labodj/resol-vbus-interface/docs/images/pcb-bottom.png

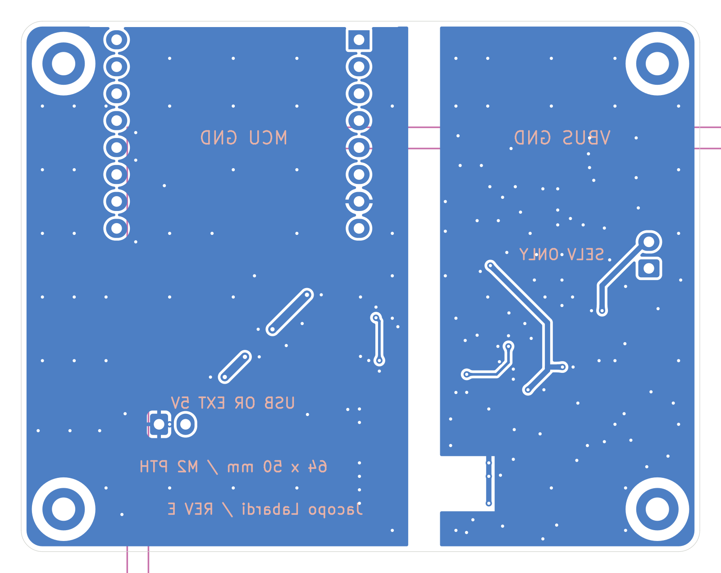
docs/images/pcb-bottom.png
