labodj/resol-vbus-interface/docs/schematic.png

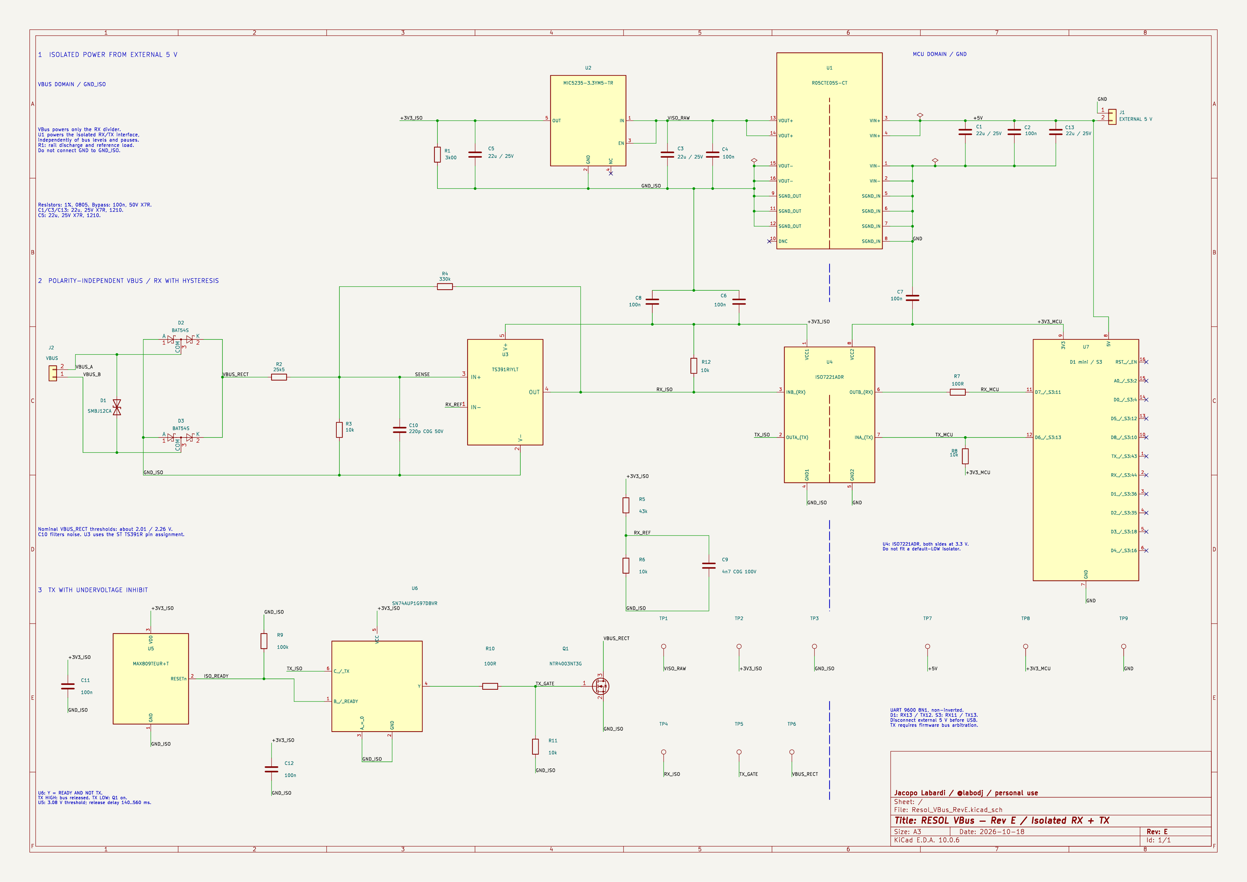
docs/schematic.png
