labodj/resol-vbus-interface/fabrication/bom.csv

References | Value | Footprint | Manufacturer | MPN | Quantity
C1,C3,C5,C13 | 22u / 25V | Capacitor_SMD:C_1210_3225Metric | Samsung Electro-Mechanics | CL32B226KAJNNNE | 4
C2,C4,C6-C8,C11,C12 | 100n | Capacitor_SMD:C_0805_2012Metric | Yageo | CC0805KRX7R9BB104 | 7
C9 | 4n7 C0G 100V | Capacitor_SMD:C_0805_2012Metric | KEMET | C0805C472J1GACTU | 1
C10 | 220p C0G 50V | Capacitor_SMD:C_0805_2012Metric | KEMET | C0805C221J5GACTU | 1
D1 | SMBJ12CA | Diode_SMD:D_SMB | Vishay | SMBJ12CA-E3/52 | 1
D2,D3 | BAT54S | Package_TO_SOT_SMD:SOT-23 | Diodes Incorporated | BAT54SQ-7-F | 2
J1 | EXTERNAL 5 V | Connector_JST:JST_XH_B2B-XH-A_1x02_P2.50mm_Vertical | JST | B2B-XH-A | 1
J2 | VBUS | Connector_JST:JST_XH_B2B-XH-A_1x02_P2.50mm_Vertical | JST | B2B-XH-A | 1
Q1 | NTR4003NT3G | Package_TO_SOT_SMD:SOT-23 | onsemi | NTR4003NT3G | 1
R1 | 3k00 | Resistor_SMD:R_0805_2012Metric | Yageo | RC0805FR-073KL | 1
R2 | 25k5 | Resistor_SMD:R_0805_2012Metric | Yageo | RC0805FR-0725K5L | 1
R3,R6,R8,R11,R12 | 10k | Resistor_SMD:R_0805_2012Metric | Yageo | RC0805FR-0710KL | 5
R4 | 330k | Resistor_SMD:R_0805_2012Metric | Yageo | RC0805FR-07330KL | 1
R5 | 43k | Resistor_SMD:R_0805_2012Metric | Yageo | RC0805FR-0743KL | 1
R7,R10 | 100R | Resistor_SMD:R_0805_2012Metric | Yageo | RC0805FR-07100RL | 2
R9 | 100k | Resistor_SMD:R_0805_2012Metric | Yageo | RC0805FR-07100KL | 1
U1 | R05CTE05S-CT | ResolVBusD:RECOM_R05CTE05S | RECOM | R05CTE05S-CT | 1
U2 | MIC5235-3.3YM5-TR | Package_TO_SOT_SMD:SOT-23-5 | Microchip Technology | MIC5235-3.3YM5-TR | 1
U3 | TS391RIYLT | Package_TO_SOT_SMD:SOT-23-5 | STMicroelectronics | TS391RIYLT | 1
U4 | ISO7221ADR | Package_SO:SOIC-8_3.9x4.9mm_P1.27mm | Texas Instruments | ISO7221ADR | 1
U5 | MAX809TEUR+T | Package_TO_SOT_SMD:SOT-23 | Analog Devices / Maxim | MAX809TEUR+T | 1
U6 | SN74AUP1G97DBVR | Package_TO_SOT_SMD:SOT-23-6 | Texas Instruments | SN74AUP1G97DBVR | 1
U7 | D1 mini / S3 | ResolVBusD:Wemos_D1_mini_2x08 | LOLIN / WEMOS |  | 1
