labodj/resol-vbus-interface/docs/schematic.pdf

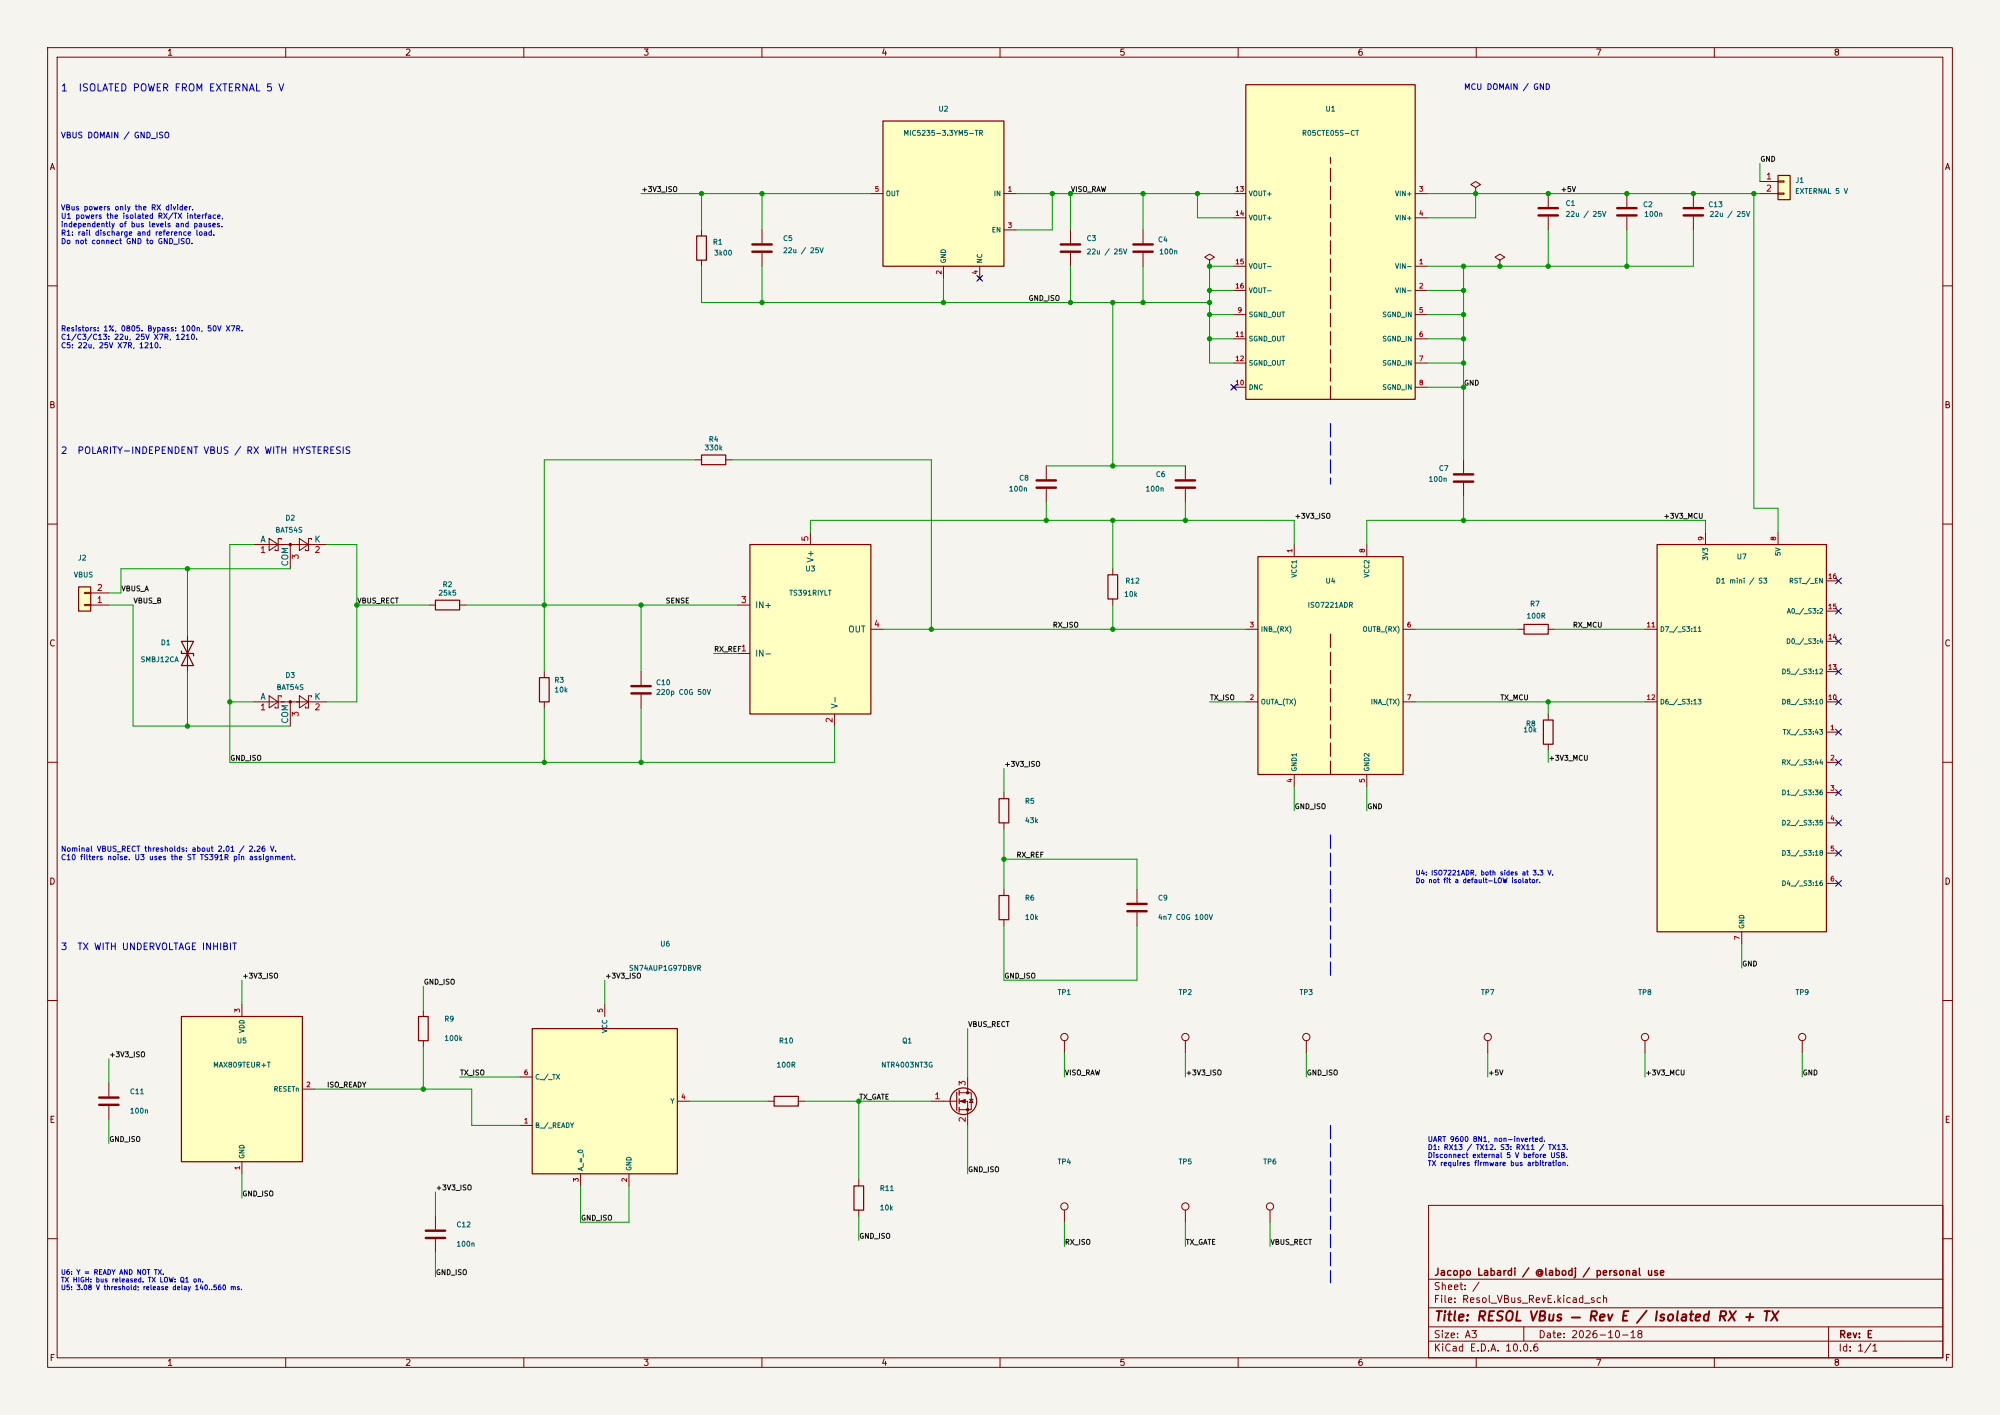
[picture p5: page 1]

Resistors: 1%, 0805. Bypass: 100n, 50V X7R. C1/C3/C13: 22u, 25V X7R, 1210. C5: 22u, 25V X7R, 1210. VBUS DOMAIN / GND_ISO 1 ISOLATED POWER FROM EXTERNAL 5 V

VBus powers only the RX divider. U1 powers the isolated RX/TX interface,

independently of bus levels and pauses. R1: rail discharge and reference load. Do not connect GND to GND_ISO.

Nominal VBUS_RECT thresholds: about 2.01 / 2.26 V. C10 filters noise. U3 uses the ST TS391R pin assignment.

U4: ISO7221ADR, both sides at 3.3 V. Do not fit a default-LOW isolator.

U6: Y = READY AND NOT TX. TX HIGH: bus released. TX LOW: Q1 on. U5: 3.08 V threshold; release delay 140..560 ms.

Jacopo Labardi / @labodj / personal use
Sheet: /
File: Resol_VBus_RevE.kicad_sch
Title: RESOL VBus — Rev E / Isolated RX + TX

Size: A3 | Rev: E | F Date: 2026-10-18
KiCad E.D.A. 10.0.6 | Id: 1/1
