labodj/resol-vbus-interface/hardware/rev-e/Resol_VBus_RevE.kicad_pcb

## KiCad design hardware/rev-e/Resol_VBus_RevE.kicad_pcb (2026-10-18)

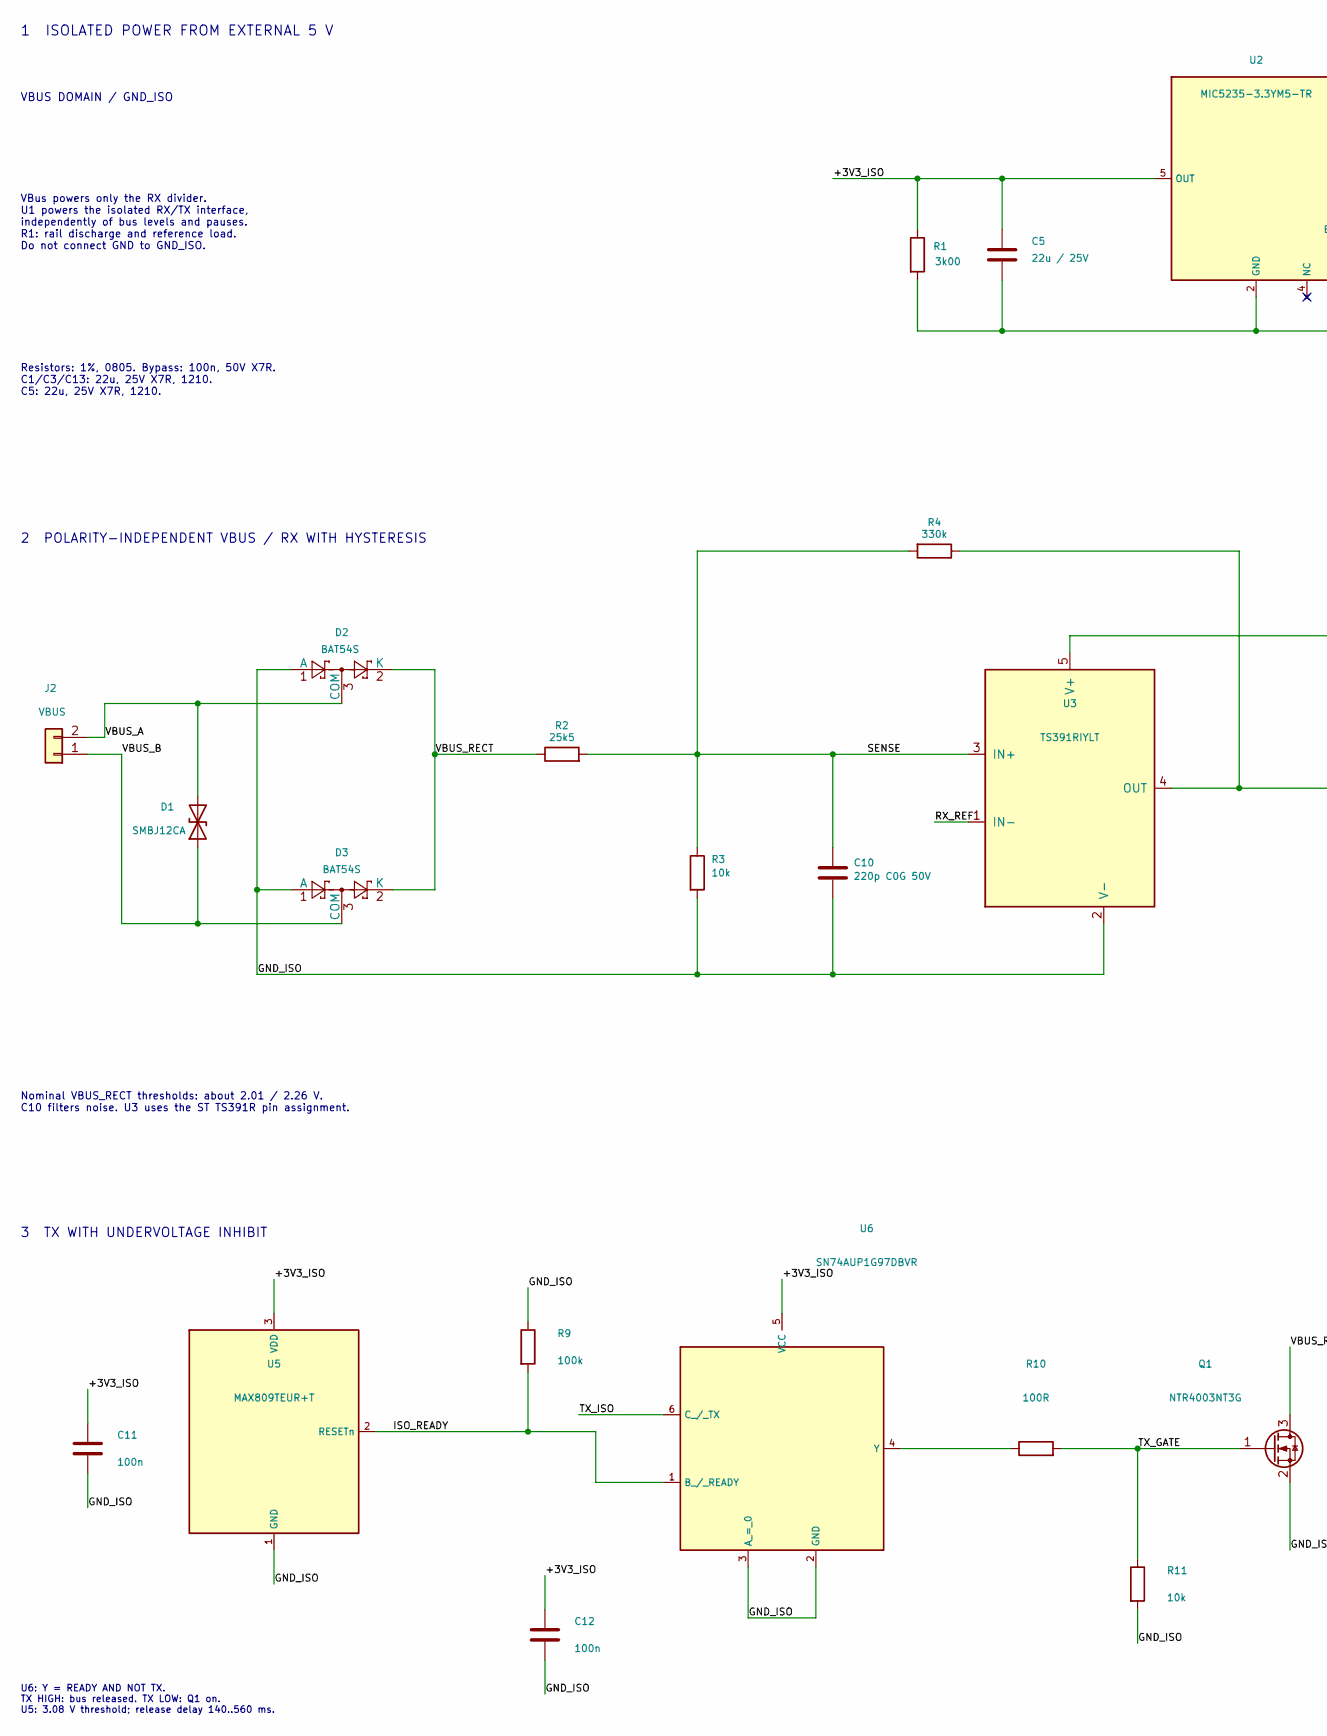
[picture p6: schematic Resol_VBus_RevE.kicad_sch, RESOL VBus — Rev E / Isolated RX + TX, part in row 1, column 1]

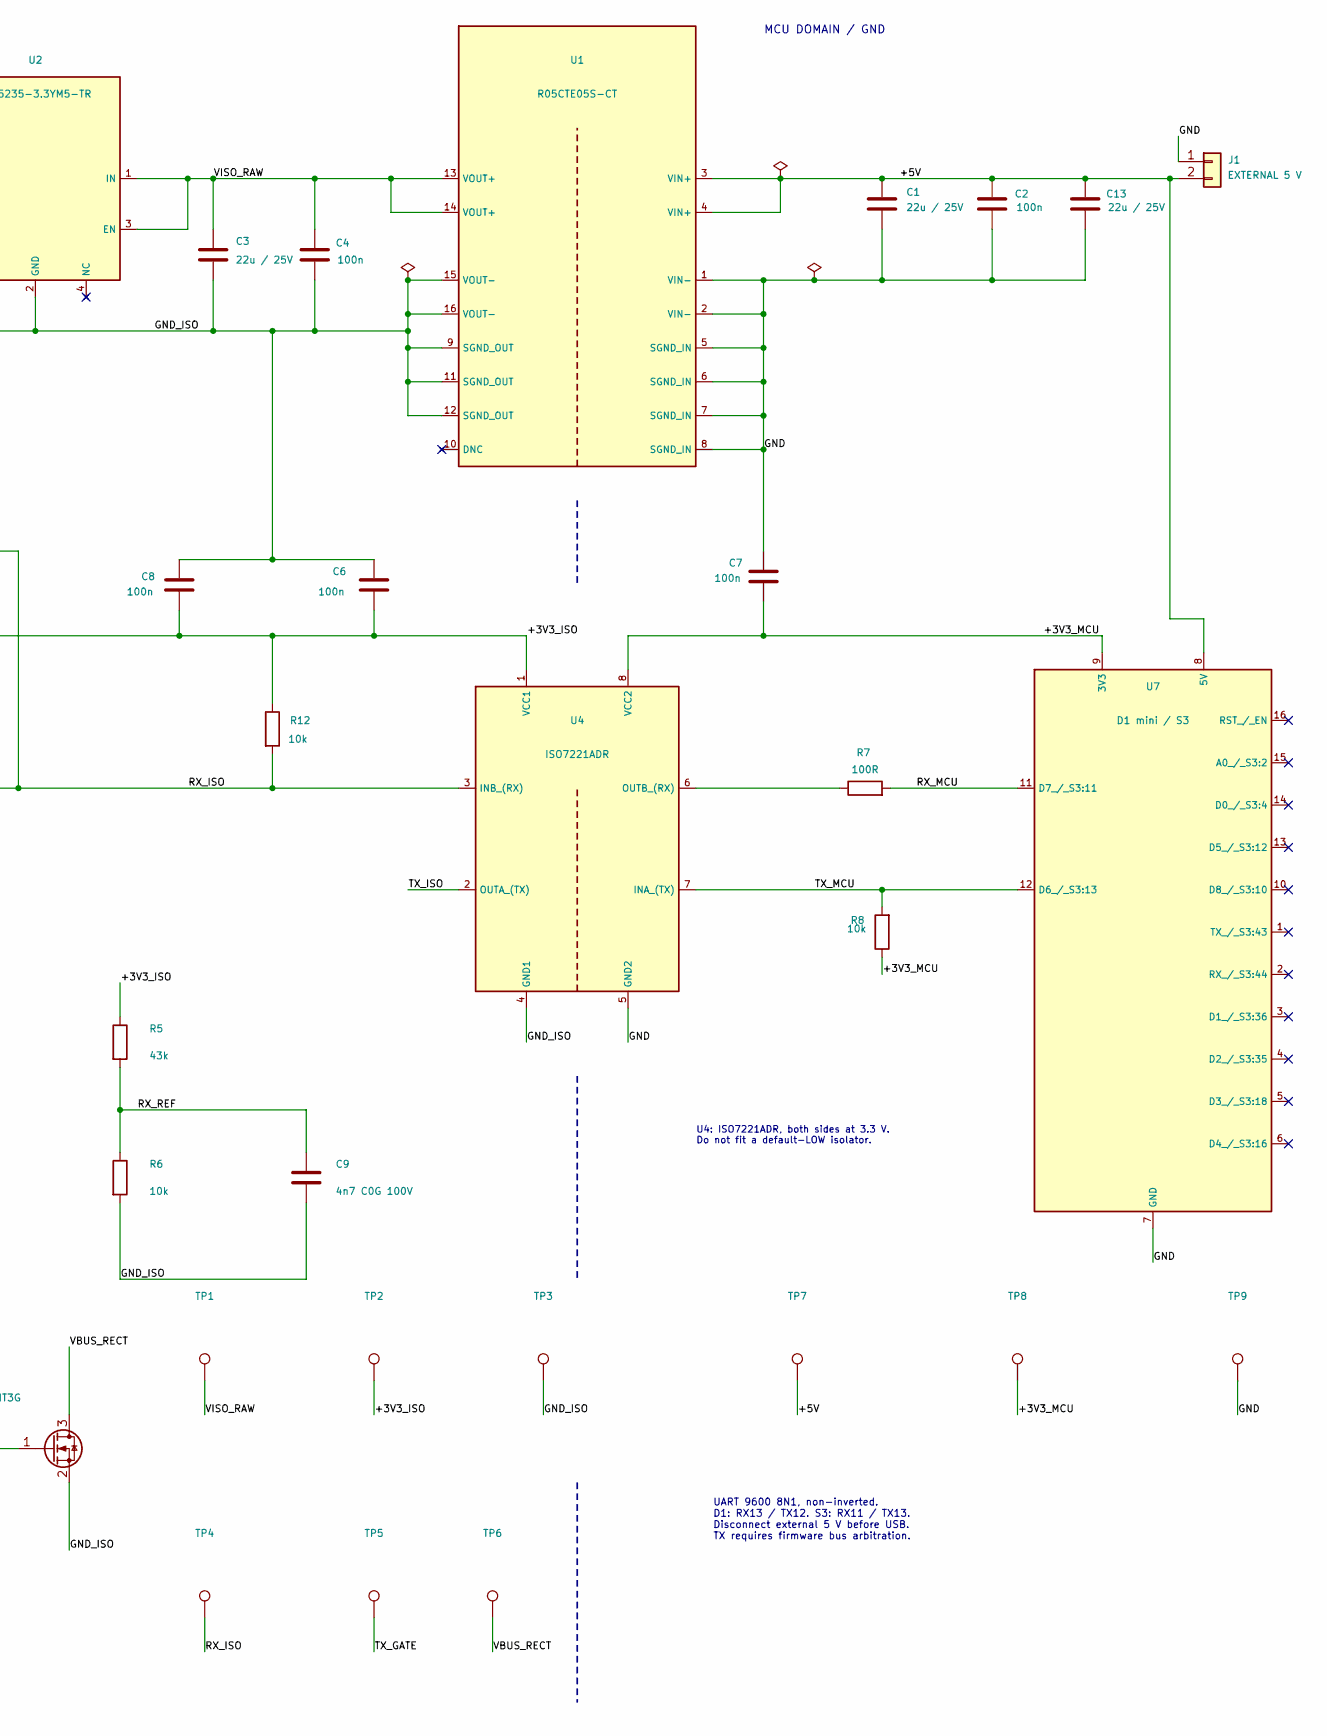
[picture p7: schematic Resol_VBus_RevE.kicad_sch, RESOL VBus — Rev E / Isolated RX + TX, part in row 1, column 2]

Parts:
C1, C3, C5, C13: 22u / 25V; C_1210_3225Metric; MPN CL32B226KAJNNNE
C2, C4, C6, C7, C8, C11, C12: 100n; C_0805_2012Metric; MPN CC0805KRX7R9BB104
C9: 4n7 C0G 100V; C_0805_2012Metric; MPN C0805C472J1GACTU
C10: 220p C0G 50V; C_0805_2012Metric; MPN C0805C221J5GACTU
D1: SMBJ12CA; D_SMB; MPN SMBJ12CA-E3/52
D2, D3: BAT54S; SOT-23; MPN BAT54SQ-7-F
J1: EXTERNAL 5 V; JST_XH_B2B-XH-A_1x02_P2.50mm_Vertical; MPN B2B-XH-A
J2: VBUS; JST_XH_B2B-XH-A_1x02_P2.50mm_Vertical; MPN B2B-XH-A
Q1: NTR4003NT3G; SOT-23; MPN NTR4003NT3G
R1: 3k00; R_0805_2012Metric; MPN RC0805FR-073KL
R2: 25k5; R_0805_2012Metric; MPN RC0805FR-0725K5L
R3, R6, R8, R11, R12: 10k; R_0805_2012Metric; MPN RC0805FR-0710KL
R4: 330k; R_0805_2012Metric; MPN RC0805FR-07330KL
R5: 43k; R_0805_2012Metric; MPN RC0805FR-0743KL
R7, R10: 100R; R_0805_2012Metric; MPN RC0805FR-07100RL
R9: 100k; R_0805_2012Metric; MPN RC0805FR-07100KL
TP1: VISO_RAW; TestPoint_Pad_D1.0mm
TP2: +3V3_ISO; TestPoint_Pad_D1.0mm
TP3: GND_ISO; TestPoint_Pad_D1.0mm
TP4: RX_ISO; TestPoint_Pad_D1.0mm
TP5: TX_GATE; TestPoint_Pad_D1.0mm
TP6: VBUS_RECT; TestPoint_Pad_D1.0mm
TP7: +5V; TestPoint_Pad_D1.0mm
TP8: +3V3_MCU; TestPoint_Pad_D1.0mm
TP9: GND; TestPoint_Pad_D1.0mm
U1: R05CTE05S-CT; RECOM_R05CTE05S; MPN R05CTE05S-CT
U2: MIC5235-3.3YM5-TR; SOT-23-5; MPN MIC5235-3.3YM5-TR
U3: TS391RIYLT; SOT-23-5; MPN TS391RIYLT
U4: ISO7221ADR; SOIC-8_3.9x4.9mm_P1.27mm; MPN ISO7221ADR
U5: MAX809TEUR+T; SOT-23; MPN MAX809TEUR+T
U6: SN74AUP1G97DBVR; SOT-23-6; MPN SN74AUP1G97DBVR
U7: D1 mini / S3; Wemos_D1_mini_2x08

Connections:
/+3V3_ISO: C5.1, C6.1, C8.1, C11.1, C12.1, R1.1, R5.1, R12.1, TP2.1 (1_1), U2.5 (OUT), U3.5 (V+), U4.1 (VCC1), U5.3 (VDD), U6.5 (VCC)
/+3V3_MCU: C7.1, R8.1, TP8.1 (1_1), U4.8 (VCC2), U7.9 (3V3)
/+5V: C1.1, C2.1, C13.1, J1.2, TP7.1 (1_1), U1.3 (VIN+), U1.4 (VIN+), U7.8 (5V)
/GND: C1.2, C2.2, C7.2, C13.2, J1.1, TP9.1 (1_1), U1.1 (VIN-), U1.2 (VIN-), U1.5 (SGND_IN), U1.6 (SGND_IN), U1.7 (SGND_IN), U1.8 (SGND_IN), U4.5 (GND2), U7.7 (GND)
/GND_ISO: C3.2, C4.2, C5.2, C6.2, C8.2, C9.2, C10.2, C11.2, C12.2, D2.1 (A), D3.1 (A), Q1.2 (S), R1.2, R3.2, R6.2, R9.1, R11.2, TP3.1 (1_1), U1.9 (SGND_OUT), U1.11 (SGND_OUT), U1.12 (SGND_OUT), U1.15 (VOUT-), U1.16 (VOUT-), U2.2 (GND), U3.2 (V-), U4.4 (GND1), U5.1 (GND), U6.2 (GND), U6.3 (A_=_0)
/ISO_READY: R9.2, U5.2 (RESETn), U6.1 (B_/_READY)
/RX_ISO: R4.1, R12.2, TP4.1 (1_1), U3.4 (OUT), U4.3 (INB_(RX))
/RX_MCU: R7.2, U7.11 (D7_/_S3:11)
/RX_REF: C9.1, R5.2, R6.1, U3.1 (IN-)
/SENSE: C10.1, R2.2, R3.1, R4.2, U3.3 (IN+)
/TX_GATE: Q1.1 (G), R10.2, R11.1, TP5.1 (1_1)
/TX_ISO: U4.2 (OUTA_(TX)), U6.6 (C_/_TX)
/TX_MCU: R8.2, U4.7 (INA_(TX)), U7.12 (D6_/_S3:13)
/VBUS_A: D1.2 (A2), D2.3 (COM), J2.2
/VBUS_B: D1.1 (A1), D3.3 (COM), J2.1
/VBUS_RECT: D2.2 (K), D3.2 (K), Q1.3 (D), R2.1, TP6.1 (1_1)
/VISO_RAW: C3.1, C4.1, TP1.1 (1_1), U1.13 (VOUT+), U1.14 (VOUT+), U2.1 (IN), U2.3 (EN)
unnamed: R7.1, U4.6 (OUTB_(RX))
unnamed: R10.1, U6.4 (Y)

Notes on the sheet:
2 POLARITY-INDEPENDENT VBUS / RX WITH HYSTERESIS
Resistors: 1%, 0805. Bypass: 100n, 50V X7R. C1/C3/C13: 22u, 25V X7R, 1210. C5: 22u, 25V X7R, 1210.
UART 9600 8N1, non-inverted. D1: RX13 / TX12. S3: RX11 / TX13. Disconnect external 5 V before USB. TX requires firmware bus arbitration.
3 TX WITH UNDERVOLTAGE INHIBIT
Nominal VBUS_RECT thresholds: about 2.01 / 2.26 V. C10 filters noise. U3 uses the ST TS391R pin assignment.
MCU DOMAIN / GND
VBUS DOMAIN / GND_ISO
1 ISOLATED POWER FROM EXTERNAL 5 V
U4: ISO7221ADR, both sides at 3.3 V. Do not fit a default-LOW isolator.
U6: Y = READY AND NOT TX. TX HIGH: bus released. TX LOW: Q1 on. U5: 3.08 V threshold; release delay 140..560 ms.
VBus powers only the RX divider. U1 powers the isolated RX/TX interface, independently of bus levels and pauses. R1: rail discharge and reference load. Do not connect GND to GND_ISO.

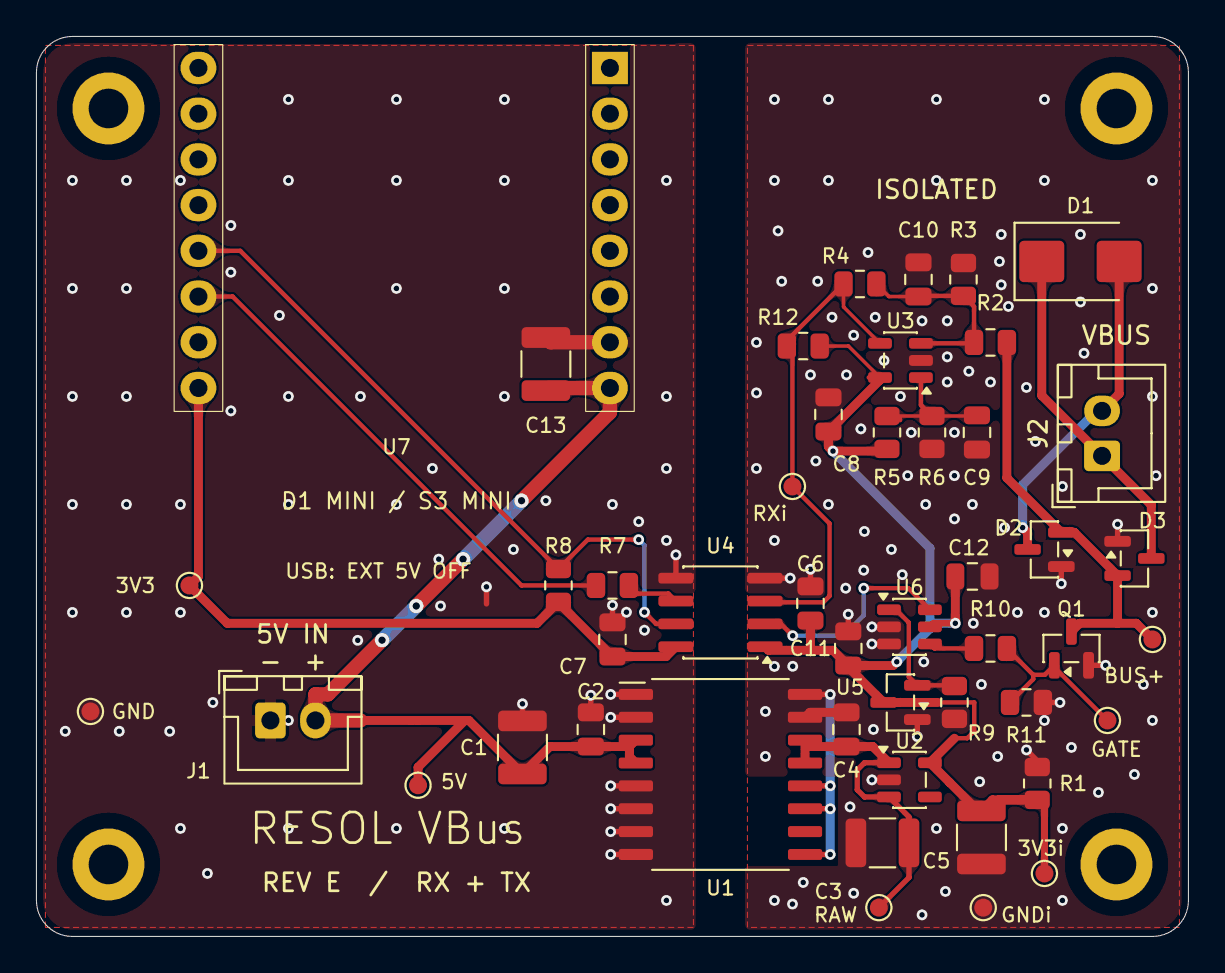
[picture p8: board Resol_VBus_RevE.kicad_pcb from above]

Board: 2 copper layers, 64.0 x 50.0 mm, 51 parts (0 on the bottom side), 19 nets.

Other parts of the board:
H1, H2, H3, H4: M2 / 2.2 mm PTH; MountingHole_2.2mm_M2_Plated_Isolated
