labodj/resol-vbus-interface/(commit log)

2026-10-18 Publish Rev E isolated VBus interface prototype
    [Resol_VBus_RevE-B_Cu.gbl, Resol_VBus_RevE-B_Mask.gbs, Resol_VBus_RevE-B_Silkscreen.gbo, Resol_VBus_RevE-Edge_Cuts.gm1, Resol_VBus_RevE-F_Cu.gtl, Resol_VBus_RevE-F_Mask.gts, Resol_VBus_RevE-F_Silkscreen.gto, Resol_VBus_RevE-NPTH.drl]
2026-10-18 Add assembled prototype photo to the README
